jbell303/esp8266-adds-station/media/update.PNG

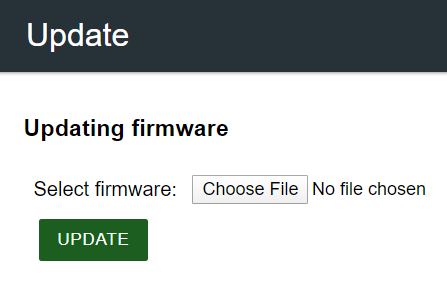
media/update.PNG
