jbell303/esp8266-adds-station/(commit log)

2019-07-28 add UI and button
2024-04-09 update aviationweather.gov client, fix MDNS
    [esp8266-adds-station.ino]
